marv/Wetterstation/README.md

Wetterstation
=============
Test 123
Test TimBr
