marv/Wetterstation/Schematics/Main.png

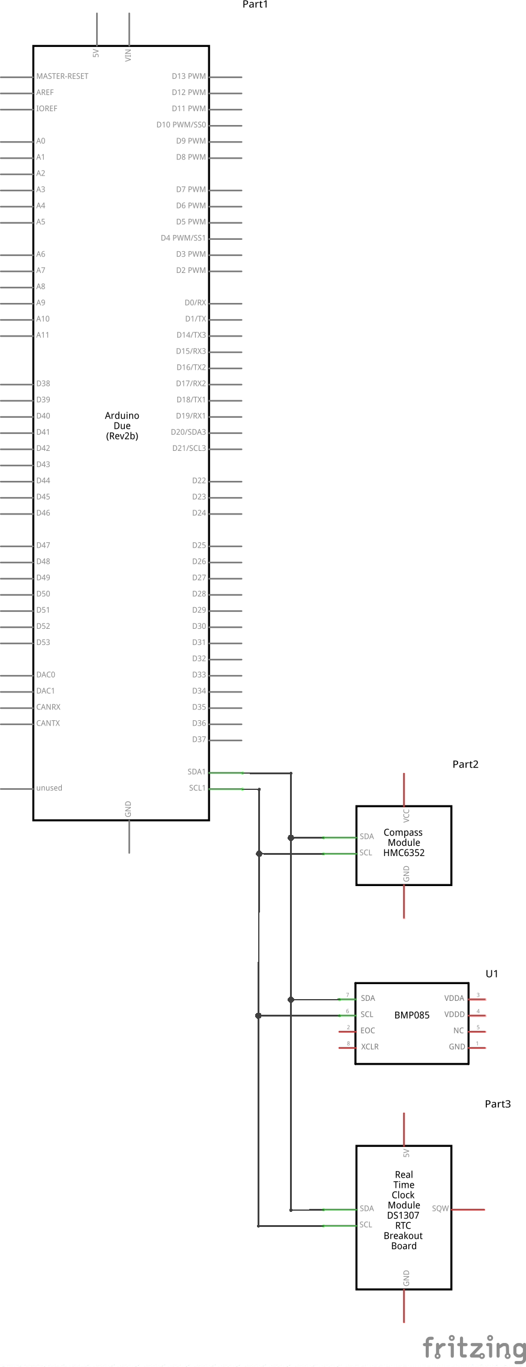
Schematics/Main.png
