marv/Wetterstation/Schematics/get_position_GPS.pdf

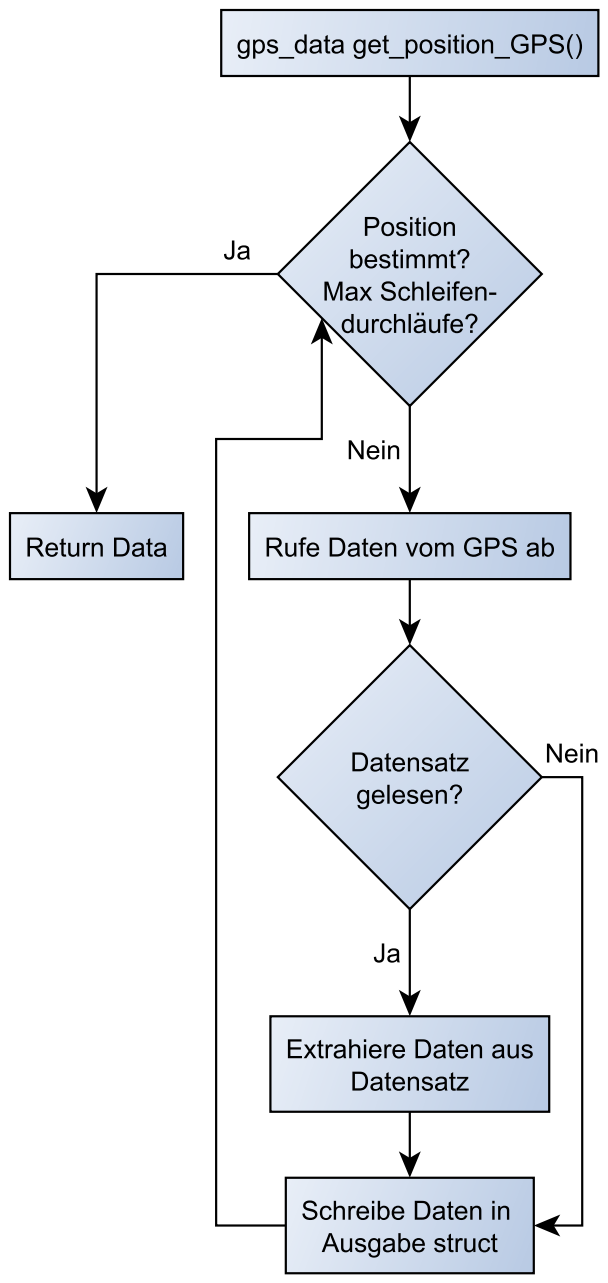
[picture p11: page 1]
