marv/Wetterstation/Schematics/init_GPS.pdf

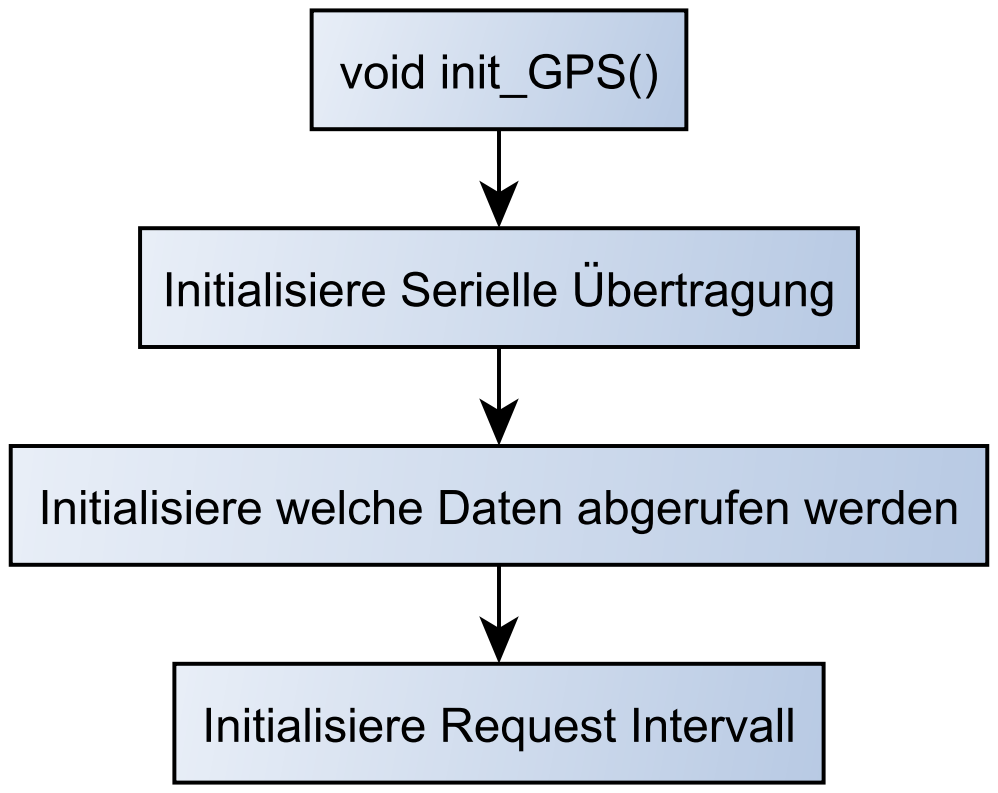
[picture p12: page 1]
