marv/Wetterstation/(commit log)

2014-10-01 Add arduino program to read anemometer measurements
2014-10-01 Add dummy schematic of arduino connections
2014-10-02 Initial Motortreiber documentation
2014-10-16 anemometer: Fix bit field access, fields need same type
    [Anemometer.h]
2014-10-16 Use pin assignments from Pinning.h
2014-10-16 Add BMP085 sensor
2014-10-16 Add HMC6352 sensor
2014-10-16 Add SHT15 sensor
2014-10-16 Extend log entry to all sensor data
2014-10-16 Kompass Library + Calib
    angepasste Kompass Library mit 2 neuen Funktionen StartCalibration()
    und StopCalibration()
2014-10-16 pinning: NTC is connected to analog pin 0
2014-10-16 Log temperature from the NTC
2014-10-23 Add MotorDriver draft
2014-10-23 DataLogger: use the current date as filename
    ATTENTION: the filename can only be 8 characters long due to FAT shortcomings
    [DataLogger.cpp]
2014-10-30 Correct wind direction reading from the anemometer
    It's has a 90 degrees offset due to our awesome setup :-)
    [Wetterstation.ino]
2014-10-30 Revert "GPS_library_absolutepath"
    This reverts commit 5c2eca1bc1d72efa57d641e38ee65ae7bb542269.
    [gps_module.cpp]
2014-10-30 Implement the motor driver
2014-10-30 Use pin 50 for ENABLE of the L293
2014-10-30 Remove obsolete pin definitions
2014-10-30 SolarPanelPositioner: stop motor when we are orientation
2014-11-06 removed bug from alarm setting
    [MCSleepMode.ino]
2014-11-06 MotorDriver: only enable chip when we use it
2014-11-06 Add solar charge current and battery voltage to data log
2014-11-06 Remove duplicate loop and setup methods, fix includes
    [RTCInternalManagement.cpp, RTCInternalManagement.h]
2014-11-06 MotorDriver: fix enable logic
    [MotorDriver.cpp, MotorDriver.h]
2014-11-06 Adapt to new motor driver enable logic
2014-11-06 Revert "minor changes in Comments and Code-style"
    This reverts commit d89a972888483b3306a8742130ca36a385f155d1.
    [MCSleepMode.cpp, MCSleepMode.h, RTCInternalManagement.h]
2014-11-06 Revert "Rename RTCInternalManagement.ino to .cpp"
    This reverts commit e6e0d42834548b723989959a8ad7953d8db84d71.
    [RTCInternalManagement.ino]
2014-11-06 Revert "Rename to MCSleepMode.ino to MCSleepMode.cpp"
    This reverts commit a22aa9a98f8807ec468ed14549ce5f49b199b367.
    [MCSleepMode.ino]
2014-11-06 Reverted unwanted changes
    concerning commit e6e0d42834548b723989959a8ad7953d8db84d71
    and
    a22aa9a98f8807ec468ed14549ce5f49b199b367
    [MCSleepMode.h, MCSleepMode.ino, RTCInternalManagement.h]
2014-12-04 Matlab_script_erweitert
    Live plot für temperatur eingebaut
2014-12-11 Include XBee header in top-level sketch (stupid arduino...)
2014-12-11 pinning: Use cable bound serial interface for debug
2014-12-11 Remove copy of XBee library
    Please place it in your Arduino libraries folder
